Jun10rS1/Projet1AB_2026/README.md

# Projet1AB_2026
Notre projet comptage de personne

## Pense bete Git

```bash
git pull
# travail travail travail
git status
git add .
git commit -m "texte intelligent"
git push
```
