Jun10rS1/Projet1AB_2026/rapport fin de séance/Projet électronique séance 3.pdf

# Projet électronique séance 3

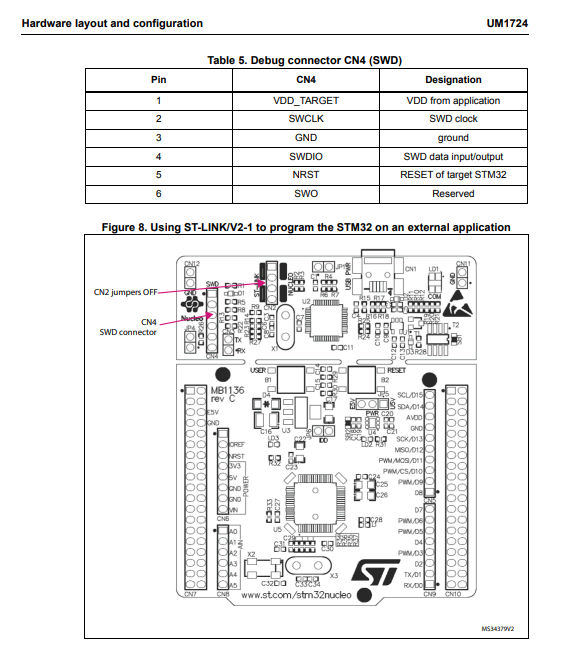
[picture p2: figure]

tableau de connection pour la programmation/débogage

## nomsConnections capteur-STM :

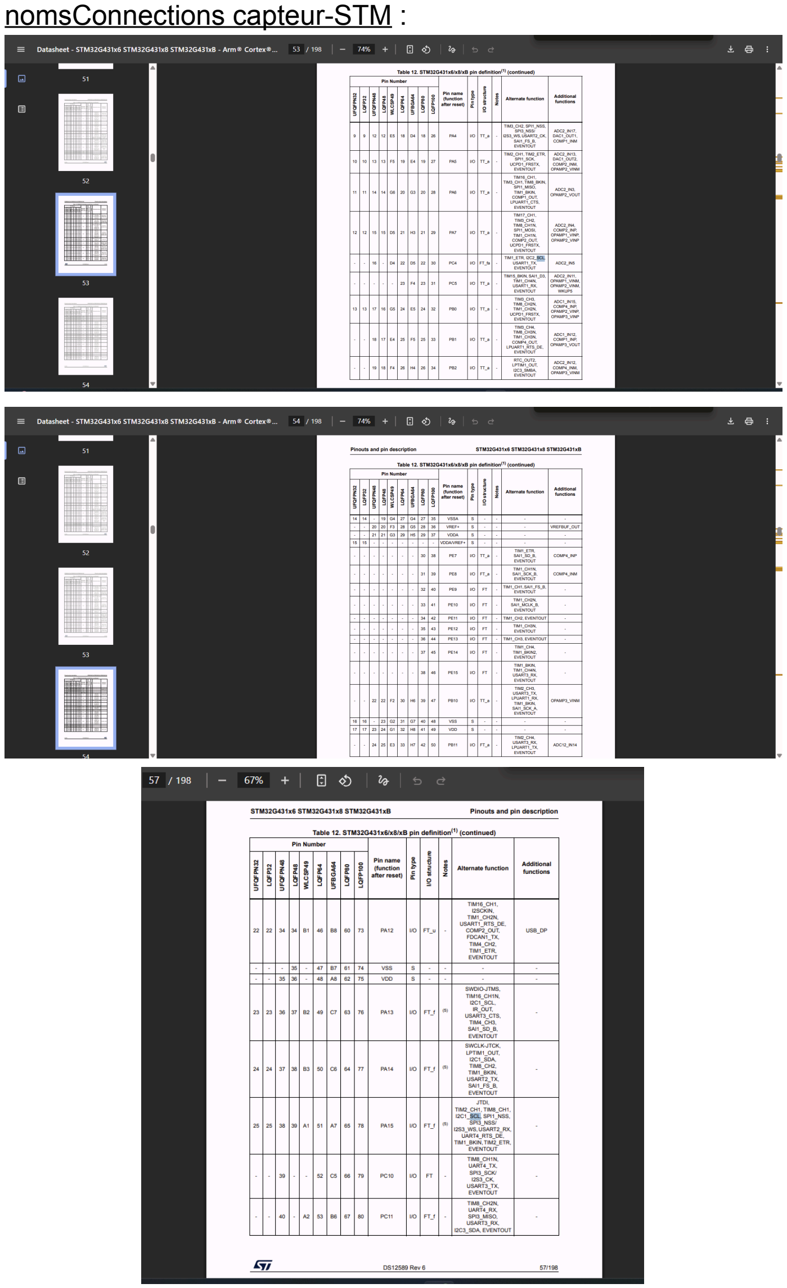
[picture p3: page 2]
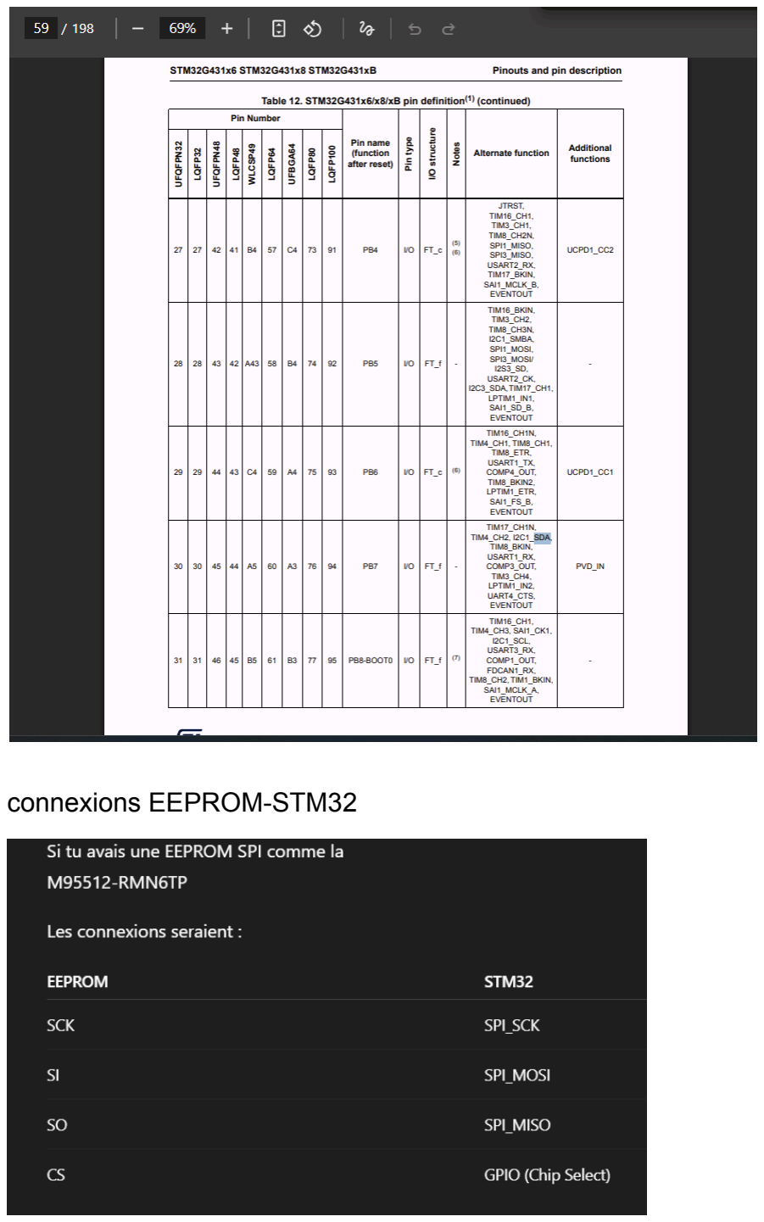
[picture p4: page 3]

## connexions EEPROM-STM32

boardhttps://www.st.com/resource/en/application_note/an5717-how-to-setup-and-run-the-vl53l5c xsatelusing-an-stm32-nucleo64-board-stmicroelectronics.pdf (http://www.st.com/resource/en/application_note/an5717-how-to-setup-and-run-the-vl53l5cxsatelusing-an-stm32-nucleo64-board-stmicroelectronics.pdf)

How to use the VL53L5CX with STMicroelectronics' X-CUBE-TOF1 Time-of-Flight sensor software packages for STM32CubeMX:

https://www.st.com/resource/en/user_manual/um2974-how-to-use-the-vl53l5cx-with-stmicroelectr onics-xcubetof1-timeofflight-sensor-software-packages-for-stm32cubemx-stmicroelectronics.pdf
