Jun10rS1/Projet1AB_2026/rapport fin de séance/Projet électronique séance 2.pdf

# Projet électronique séance 2

## Assignation des tâches entre la séance 1 et la séance 2 :

- Maël : finir recherches sur l’EEPROM (datasheets …).

### - Gaëtan : finir recherches sur les capteurs pour savoir quel

type de connecteur SWD utiliser.

### - Imane : commencer à trouver comment avoir un projet STM32

fonctionnel pour faire fonctionner le connecteur.

### - Junior : créer un Drive où on pourra mettre tous les fichiers qu’on créera et toutes les documentations techniques comme les datasheets ou les liens déposés dans les différents

comptes-rendus => plutôt un Git.

### Conditions de mesure avec le capteur VL53L5CX (cf datasheet VL53L5CX p.21) :

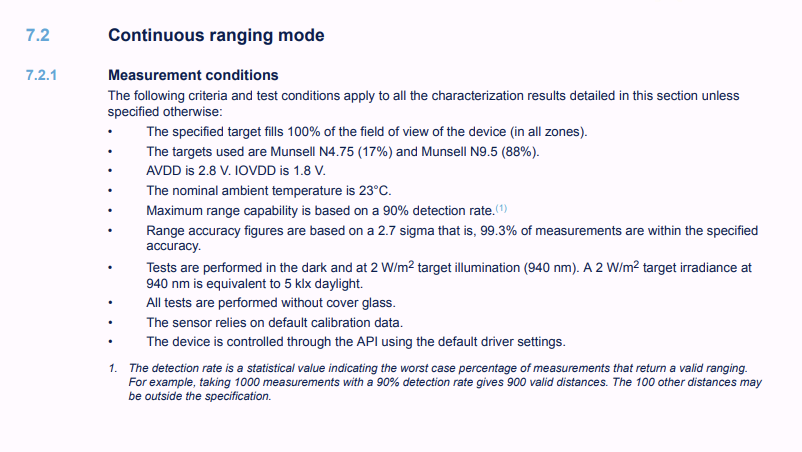
[picture p5: figure]

### - comment avoir un projet STM32 fonctionnel pour faire fonctionner le connecteur:

Dans notre projet, on utilise :

- une carte NUCLEO
- deux capteurs
- TeraTerm pour voir les données sur le PC

Donc on va probablement utiliser :

- I2C pour communiquer entre la STM32 et les capteurs
- UART pour envoyer les données vers le PC (affichage dans TeraTerm)

Etapes:

- Créer un nouveau projet avec la bonne carte (NUCLEO-L476)
- Pour l’affichage sur le PC → UART

Pour afficher les données dans TeraTerm, on utilise UART2.

Dans CubeIDE :

Activer USART2, Mode Asynchronous,Baud rate : 115200 et 8 bits

- Pour les capteurs → I2C(pas sûre si le prof a fait ça)

Les capteurs communiquent avec la STM32 en I2C.

Donc dans STM32CubeIDE : On active I2C1 ,Les pins SDA et SCL se configurent automatiquement et On laisse la fréquence à 100 kHz

- Utilisation de TeraTerm

TeraTerm est un logiciel de terminal série.

Il permet de :voir les données envoyées par la carte, tester si la communication fonctionne
et afficher le compteur en direct

Configuration :

- Brancher la carte en USB
- Ouvrir TeraTerm
- Choisir le bon port COM
- Régler le baud rate à 115200

Connecteur SWD pour le PCB : Conn_02x05_Top_Bottom.

Pour la semaine prochaine :inventaire des composants

pdf du schéma kicad

pdf du schéma pcb (selon l’avancement)

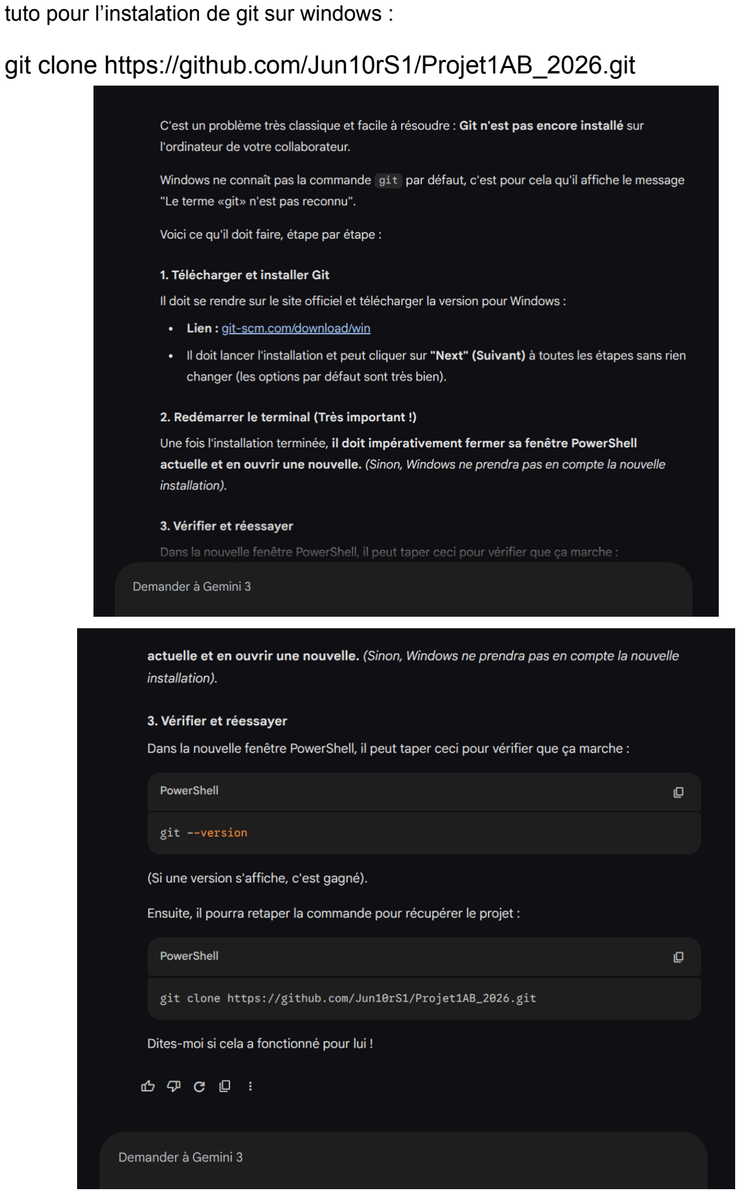
[picture p6: page 4]

tuto pour l’instalation de git sur windows :

git clone https://github.com/Jun10rS1/Projet1AB_2026.git

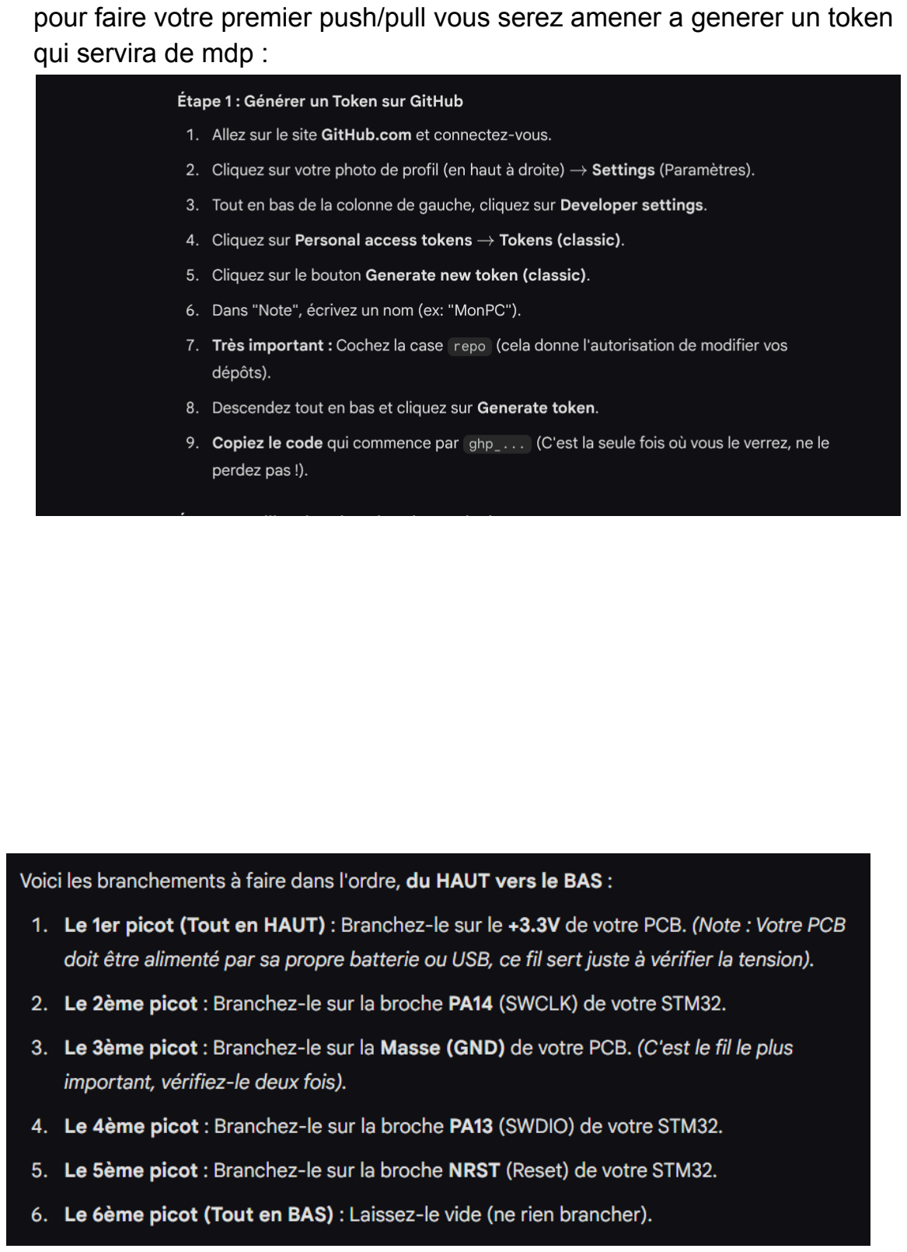
[picture p7: page 5]

pour faire votre premier push/pull vous serez amener a generer un token qui servira de mdp :

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
n : g

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
