Jun10rS1/Projet1AB_2026/rapport fin de séance/Project électronique séance 4.pdf

## Project électronique séance 4

Structure du code :

1 2 3 4 5 6 7 8

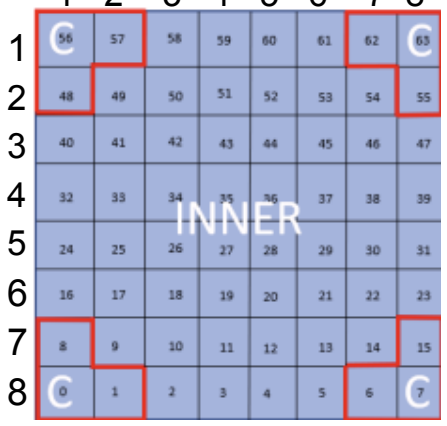
[picture p8: figure]

On prend deux colonnes de référence par côté de la matrice, par exemple les colonnes 2 et 4 pour le côté gauche, et la colonne 8 pour le côté droit :

- Si les distances par rapport au capteur sur la colonne 2 diminuent jusqu’à être inférieures seuil choisi avant que les distances de la colonne 4 ne passent en dessous du seuil, alors le capteur considère que quelque chose arrive par le côté gauche.
- Ensuite, si après ça les distances par rapport au capteur de la colonne 8 diminuent en dessous du seuil pour ensuite repasser au dessus du seuil, alors cela signifie que le capteur considère que quelque chose a traversé la zone du capteur : => Le capteur ajoute alors 1 au compteur de passages.
- De même dans l’autre sens en prenant cette fois en compte les colonnes 7 et 5 pour le côté droit, et la colonne 1 pour le côté gauche (côté de sortie) :
=> Le compteur retire alors 1 au compteur de passages.

a faire sur git a la suite (pour gaetan ) :

git fetch origin

git reset --hard origin/main

(optionelew mais recommandé ) :
git clean -fd

à faire pour la prochaine séance :
Travailler chacun sur code et communiquer en cas.
