Jun10rS1/Projet1AB_2026/Projet PCB kiCad/Projet PCB kiCad - Copie/Projet électronique séance 3 (liste de composant G4).pdf

# Projet électronique (G4 comptage)

Liste des composants :

Référence | Valeur / Modèle | Empreinte utillisé
C1, C2, C7 | 1u | Capacitor_SMD:C_0603_1608Metri c
C3, C9, C10 | 100n | Capacitor_SMD:C_0603_1608Metri c
C6 | 10n | Capacitor_SMD:C_0603_1608Metri c
C8 | 4u | Capacitor_SMD:C_0603_1608Metri c
D1, D2 | LED_Small | LED_SMD:LED_0201_0603Metric
H1 - H4 | Mounting Hole | MountingHole_3.2mm_M3
IC1 (EEPROM) | M95512-RMN6TP | Package_SO:SOIC-8_3.9x4.9mm
J1 | Conn_01x02 | JST_XH_B2B-XH-A_1x02_P2.50m m

J5 | Conn_01x09_Pin | PinSocket_1x09_P2.54mm
J6 | Conn_02x05 | PinHeader_2x05_P2.54mm
L1 | 39n | Inductor_SMD:L_0805_2012Metric
R1 | 10k | Resistor_SMD:R_0201_0603Metric
R3, R4 | 1k | Resistor_SMD:R_0201_0603Metric
U2 | BU33SD5WG-TR | Package_TO_SOT_SMD:SOT-23-5
U4 | STM32G431K8Tx | Package_QFP:LQFP-32_7x7mm
