Jun10rS1/Projet1AB_2026/Projet PCB kiCad/Projet PCB kiCad - Copie/PDF/PCB projet fin séance 4.pdf

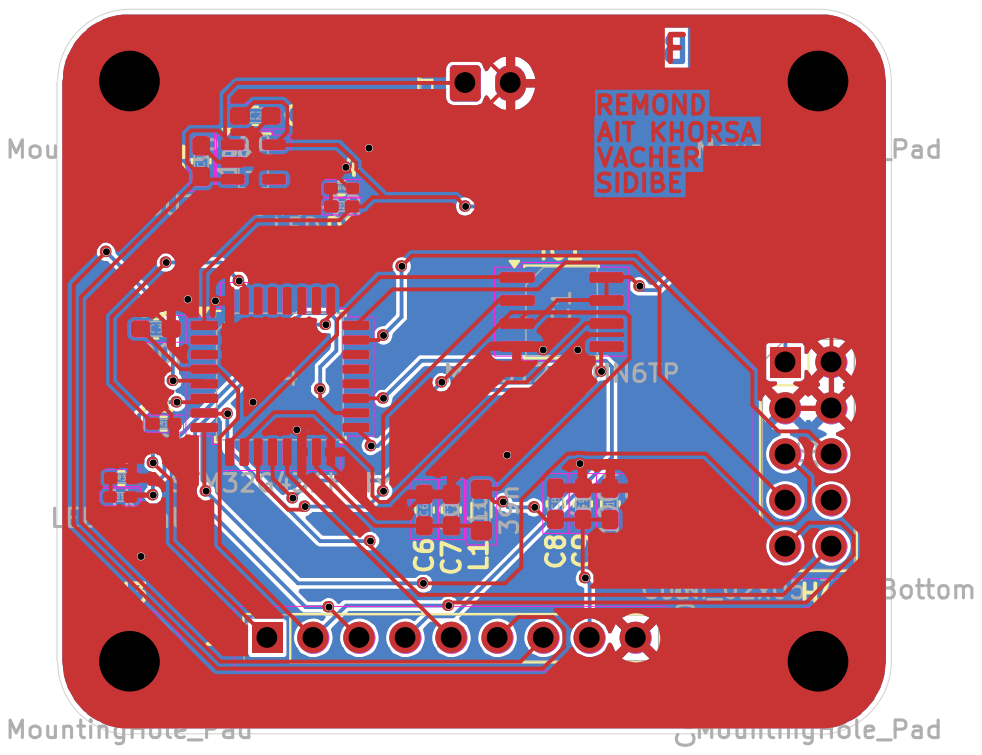
[picture p9: page 1]
