Jun10rS1/Projet1AB_2026/Projet PCB kiCad/Projet PCB kiCad - Copie/PDF/Schéma fin séance 3.pdf

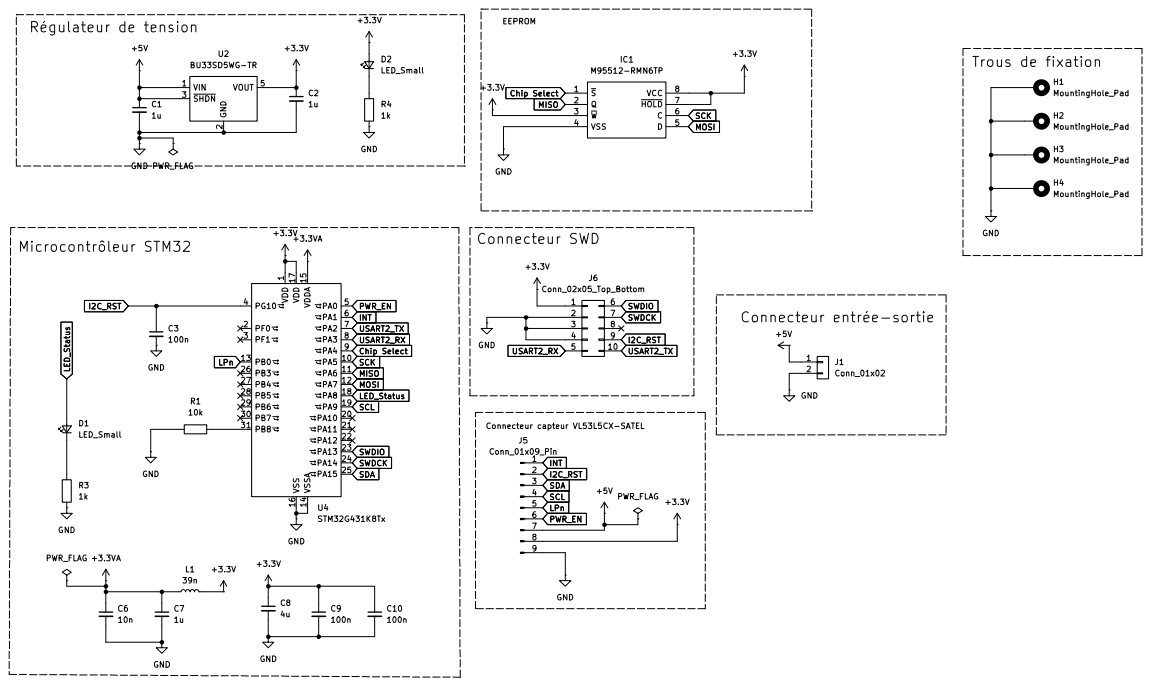
[picture p10: page 1]
