Jun10rS1/Projet1AB_2026/Projet PCB kiCad/Projet PCB kiCad - Copie/PDF/PCB fin séance 2.pdf

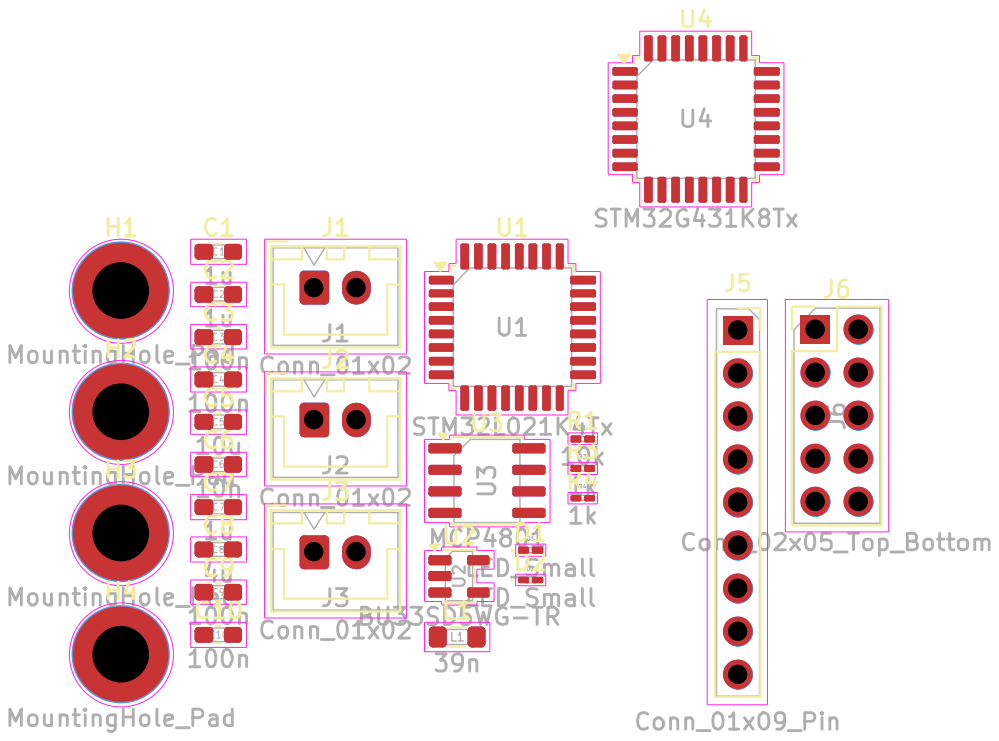
[picture p11: page 1]
