Jun10rS1/Projet1AB_2026/Projet PCB kiCad/Projet PCB kiCad - Copie/PDF/Schéma fin séance 2.pdf

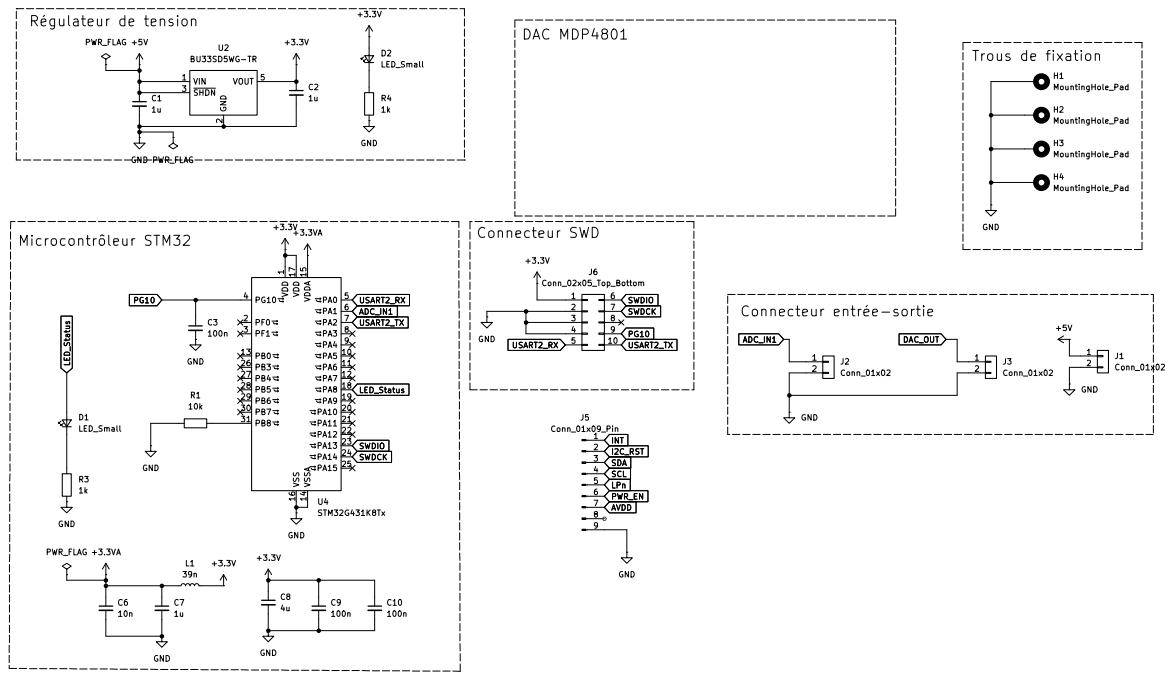
[picture p12: page 1]
