Jun10rS1/Projet1AB_2026/(list of files, drawings)

Other design files:
LIB_M95512-RMN6TP/M95512-RMN6TP/Altium/M95512-RMN6TP.SchLib
LIB_M95512-RMN6TP/M95512-RMN6TP/Altium/SOIC127P600X175-8N.PcbLib
