Jun10rS1/Projet1AB_2026/Projet PCB kiCad/Projet PCB kiCad - Copie/Projet PCB kiCad.kicad_pcb

## KiCad design Projet PCB kiCad/Projet PCB kiCad - Copie/Projet PCB kiCad.kicad_pcb (2026-03-16, an earlier design)

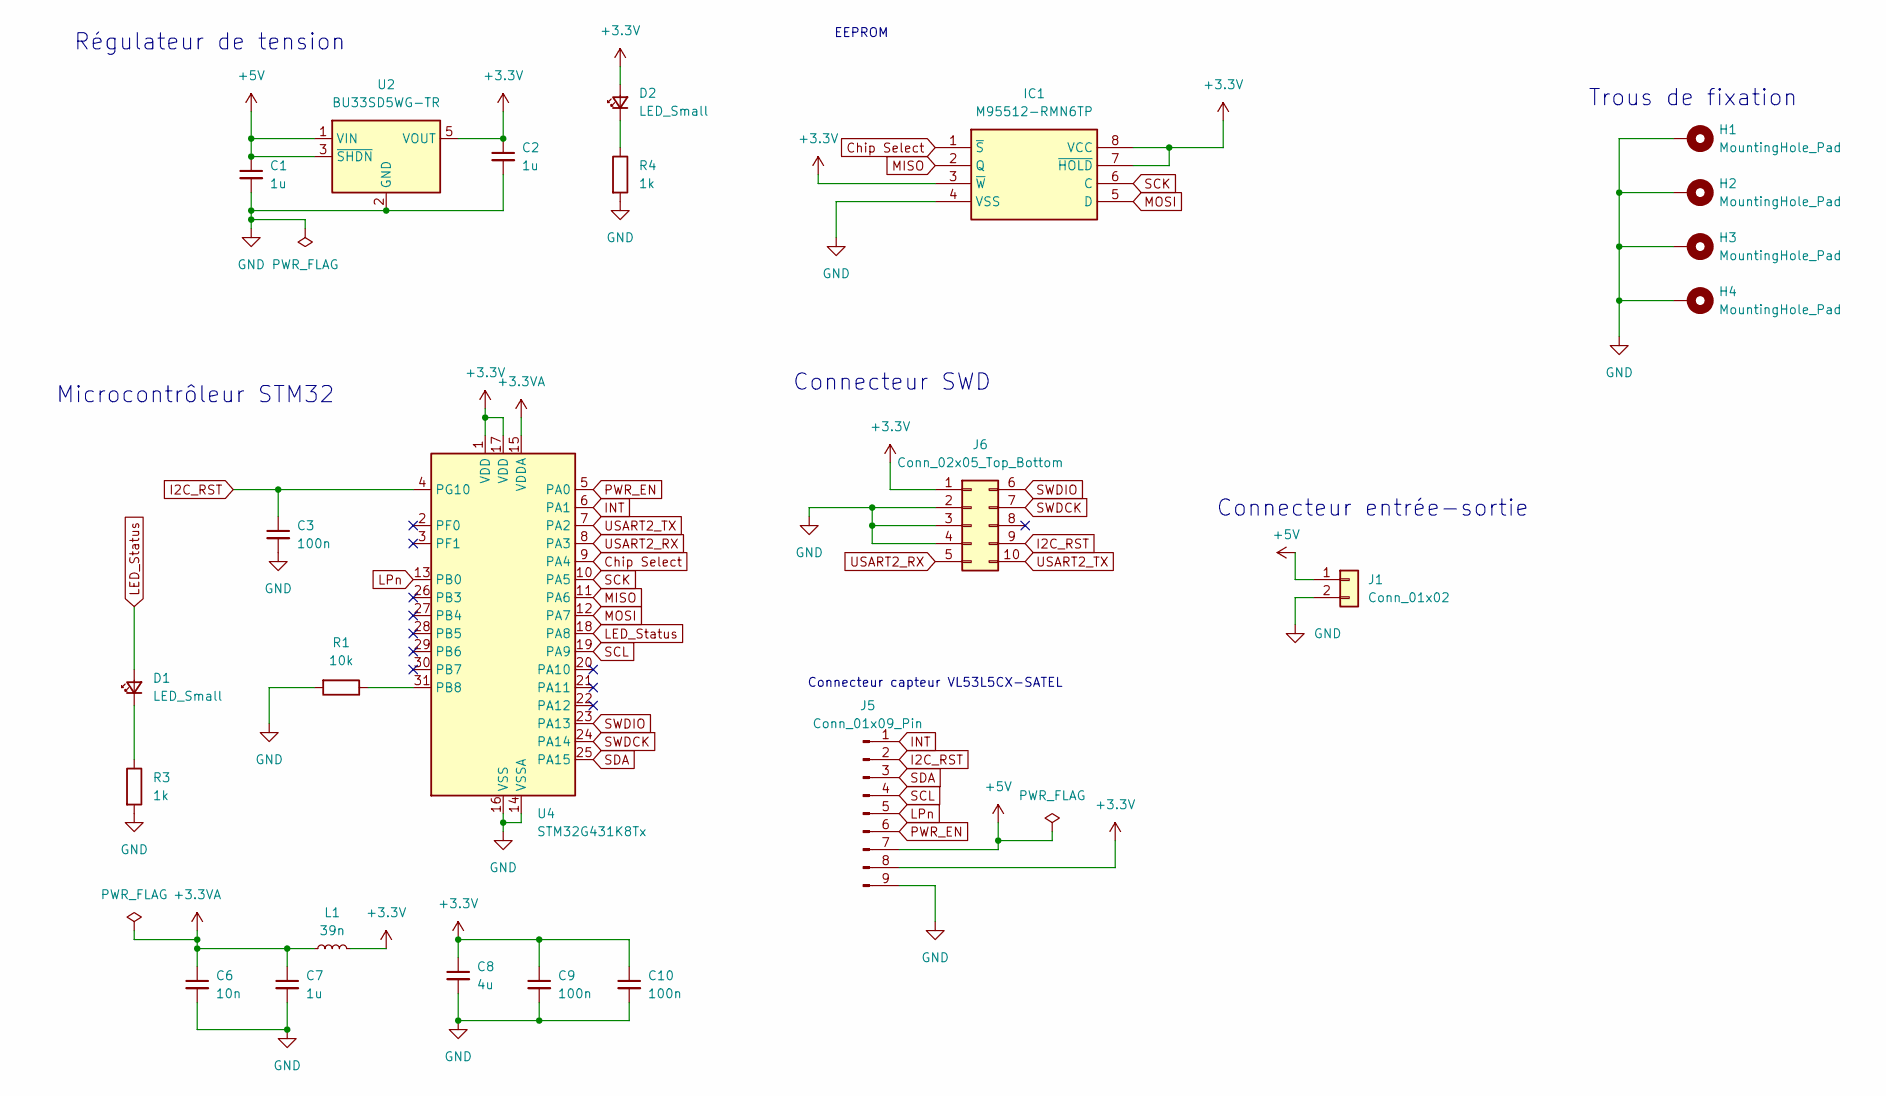
[picture p13: schematic Projet PCB kiCad.kicad_sch, Projet électronique Rémond, Ait Khorsa, Sidibe, Vacher]

Parts:
C1, C2, C7: 1u; C_0603_1608Metric_Pad1.08x0.95mm_HandSolder
C3, C9, C10: 100n; C_0603_1608Metric_Pad1.08x0.95mm_HandSolder
C6: 10n; C_0603_1608Metric_Pad1.08x0.95mm_HandSolder
C8: 4u; C_0603_1608Metric_Pad1.08x0.95mm_HandSolder
D1, D2: LED_Small; LED_0402_1005Metric_Pad0.77x0.64mm_HandSolder
H1, H2, H3, H4: MountingHole_Pad; MountingHole_3.2mm_M3_DIN965_Pad
IC1: M95512-RMN6TP; SOIC-8_3.9x4.9mm_P1.27mm; Mouser Part Number 511-M95512-RMN6TP
J1: Conn_01x02; JST_XH_B2B-XH-A_1x02_P2.50mm_Vertical
J5: Conn_01x09_Pin; PinSocket_1x09_P2.54mm_Vertical
J6: Conn_02x05_Top_Bottom; PinHeader_2x05_P2.54mm_Vertical
L1: 39n; L_0805_2012Metric_Pad1.05x1.20mm_HandSolder
R1: 10k; R_0402_1005Metric_Pad0.72x0.64mm_HandSolder
R3, R4: 1k; R_0402_1005Metric_Pad0.72x0.64mm_HandSolder
U2: BU33SD5WG-TR; SOT-23-5
U4: STM32G431K8Tx; LQFP-32_7x7mm_P0.8mm

Connections:
+3.3V: C2.1, C8.1, C9.1, C10.1, D2.2 (A), IC1.3 (~W), IC1.7 (~HOLD), IC1.8 (VCC), J5.8, J6.1, L1.2, U2.5 (VOUT), U4.1 (VDD), U4.17 (VDD)
+3.3VA: C6.1, C7.1, L1.1, U4.15 (VDDA)
+5V: C1.1, J1.1, J5.7, U2.1 (VIN), U2.3 (~SHDN)
Chip Select: IC1.1 (~S), U4.9 (PA4)
GND: C1.2, C2.2, C3.2, C6.2, C7.2, C8.2, C9.2, C10.2, H1.1, H2.1, H3.1, H4.1, IC1.4 (VSS), J1.2, J5.9, J6.2, J6.3, J6.4, R1.2, R3.2, R4.2, U2.2 (GND), U4.14 (VSSA), U4.16 (VSS), U4.32 (VSS)
I2C_RST: C3.1, J5.2, J6.9, U4.4 (PG10)
INT: J5.1, U4.6 (PA1)
LED_Status: D1.2 (A), U4.18 (PA8)
LPn: J5.5, U4.13 (PB0)
MISO: IC1.2 (Q), U4.11 (PA6)
MOSI: IC1.5 (D), U4.12 (PA7)
unnamed: D1.1 (K), R3.1
unnamed: D2.1 (K), R4.1
unnamed: R1.1, U4.31 (PB8)
PWR_EN: J5.6, U4.5 (PA0)
SCK: IC1.6 (C), U4.10 (PA5)
SCL: J5.4, U4.19 (PA9)
SDA: J5.3, U4.25 (PA15)
SWDCK: J6.7, U4.24 (PA14)
SWDIO: J6.6, U4.23 (PA13)
USART2_RX: J6.5, U4.8 (PA3)
USART2_TX: J6.10, U4.7 (PA2)

Notes on the sheet:
Trous de fixation
Connecteur entrée-sortie
Microcontrôleur STM32
Connecteur SWD
Régulateur de tension
EEPROM
Connecteur capteur VL53L5CX-SATEL

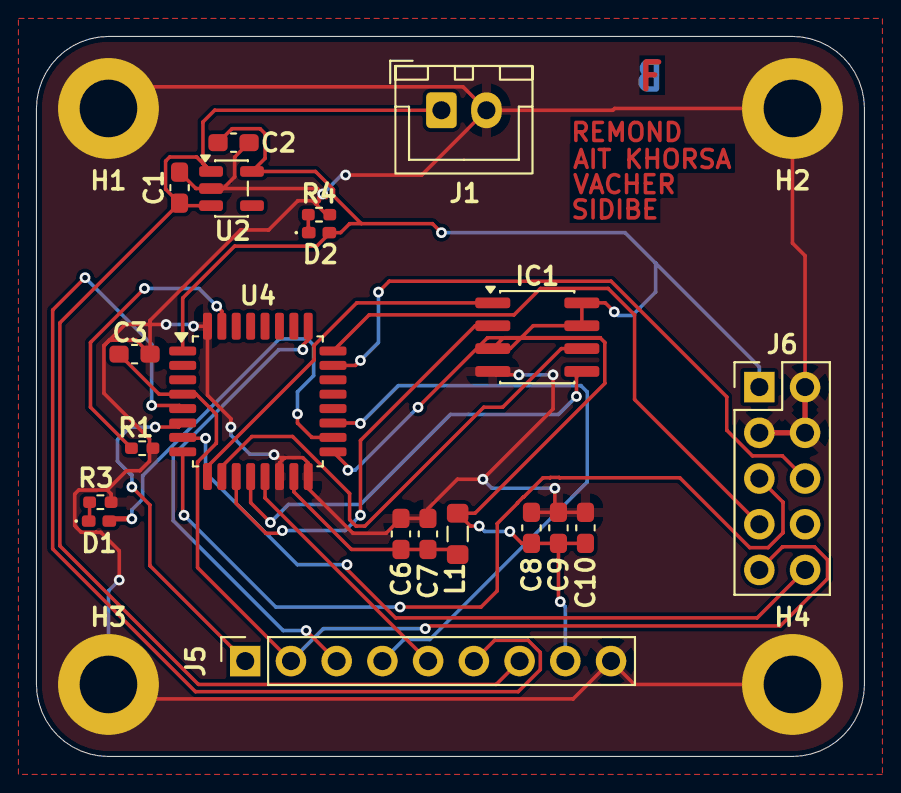
[picture p14: board Projet PCB kiCad.kicad_pcb from above]

Board: 4 copper layers, 46.0 x 40.0 mm, 24 parts (0 on the bottom side), 22 nets.
