Jun10rS1/Projet1AB_2026/Comptage_Presence4/Core/Src/main.c

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
/* Includes ------------------------------------------------------------------*/
#include "main.h"

/* USER CODE BEGIN Includes */
#include "vl53l5cx_api.h"
/* USER CODE END Includes */

/* USER CODE BEGIN PD */
#define HAL_UART_MODULE_ENABLED
/* USER CODE END PD */

I2C_HandleTypeDef hi2c2;

/* USER CODE BEGIN PV */
VL53L5CX_Configuration 	Dev;
VL53L5CX_ResultsData 	Results;

#define DIST_THRESHOLD_MM 1000

typedef enum {
    STATE_IDLE,
    STATE_WAIT_EXIT_RIGHT,
    STATE_WAIT_EXIT_LEFT
} CountState_t;

CountState_t currentState = STATE_IDLE;
int32_t passageCounter = 0;
uint8_t flagTargetInExitCol = 0;
/* USER CODE END PV */

void SystemClock_Config(void);
static void MX_GPIO_Init(void);
static void MX_I2C2_Init(void);
/* USER CODE BEGIN PFP */
uint32_t Get_Column_Average(VL53L5CX_ResultsData *pResults, uint8_t col_index);
/* USER CODE END PFP */

/**
  * @brief  The application entry point.
  * @retval int
  */
int main(void)
{

  /* MCU Configuration--------------------------------------------------------*/

  /* Reset of all peripherals, Initializes the Flash interface and the Systick. */
  HAL_Init();

  /* Configure the system clock */
  SystemClock_Config();

  /* Initialize all configured peripherals */
  MX_GPIO_Init();
  MX_I2C2_Init();
  /* USER CODE BEGIN 2 */
  /* USER CODE BEGIN 2 */

    HAL_GPIO_WritePin(GPIOB, GPIO_PIN_0, GPIO_PIN_RESET);
    HAL_Delay(20);
    HAL_GPIO_WritePin(GPIOB, GPIO_PIN_0, GPIO_PIN_SET);
    HAL_Delay(100);

    Dev.platform.address = 0x52;
    Dev.platform.i2c_handle = &hi2c2;

    uint8_t isAlive = 0;
    uint8_t status = vl53l5cx_is_alive(&Dev, &isAlive);

    if (status == 0 && isAlive) {
        printf("Capteur détecté\r\n");
        vl53l5cx_init(&Dev);
        vl53l5cx_set_resolution(&Dev, VL53L5CX_RESOLUTION_8X8);
        vl53l5cx_set_ranging_frequency_hz(&Dev, 15);
        vl53l5cx_start_ranging(&Dev);
    } else {
        printf("ERREUR : Capteur non détecté\r\n");
    }
  /* USER CODE END 2 */

  /* Infinite loop */
  /* USER CODE BEGIN WHILE */
    while (1)
      {
          uint8_t isReady = 0;
          vl53l5cx_check_data_ready(&Dev, &isReady);

          if (isReady) {
              vl53l5cx_get_ranging_data(&Dev, &Results);
              uint32_t avgCol0 = Get_Column_Average(&Results, 0);
              uint32_t avgCol3 = Get_Column_Average(&Results, 3);
              uint32_t avgCol4 = Get_Column_Average(&Results, 4);
              uint32_t avgCol7 = Get_Column_Average(&Results, 7);

              switch(currentState) {

                  case STATE_IDLE:
                      if (avgCol3 < DIST_THRESHOLD_MM) {
                          currentState = STATE_WAIT_EXIT_RIGHT;
                          flagTargetInExitCol = 0;
                      }
                      else if (avgCol4 < DIST_THRESHOLD_MM) {
                          currentState = STATE_WAIT_EXIT_LEFT;
                          flagTargetInExitCol = 0;
                      }
                      break;

                  case STATE_WAIT_EXIT_RIGHT:
                      if (avgCol7 < DIST_THRESHOLD_MM) {
                          flagTargetInExitCol = 1;
                      }
                      else if (flagTargetInExitCol && avgCol7 >= DIST_THRESHOLD_MM) {
                          passageCounter++;
                          currentState = STATE_IDLE;
                      }
                      break;

                  case STATE_WAIT_EXIT_LEFT:
                      if (avgCol0 < DIST_THRESHOLD_MM) {
                          flagTargetInExitCol = 1;
                      }
                      else if (flagTargetInExitCol && avgCol0 >= DIST_THRESHOLD_MM) {
                          passageCounter--;
                          currentState = STATE_IDLE;
                      }
                      break;
              }
          }
    /* USER CODE END WHILE */

    /* USER CODE BEGIN 3 */
  }

  /* USER CODE END 3 */
}

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
/* USER CODE BEGIN 4 */
uint32_t Get_Column_Average(VL53L5CX_ResultsData *pResults, uint8_t col_index) {
    uint32_t sum = 0;
    uint8_t valid_zones = 0;

    for (int row = 0; row < 8; row++) {
        uint8_t zone = (row * 8) + col_index;

        if (pResults->target_status[VL53L5CX_NB_TARGET_PER_ZONE * zone] == 5 ||
            pResults->target_status[VL53L5CX_NB_TARGET_PER_ZONE * zone] == 9) {

            sum += pResults->distance_mm[VL53L5CX_NB_TARGET_PER_ZONE * zone];
            valid_zones++;
        }
    }

    if (valid_zones == 0) return 9999;
    return (sum / valid_zones);
}
/* USER CODE END 4 */
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
