Jun10rS1/Projet1AB_2026/Comptage_Presence/Comptage_Presence.ioc

Mcu.UserName=STM32L476RGTx
PA2.GPIO_Label=USART_TX
PA2.Signal=USART2_TX
PA3.GPIO_Label=USART_RX
PA3.Signal=USART2_RX
PA4.Signal=GPIO_Output
PA5.Signal=SPI1_SCK
PA6.Signal=SPI1_MISO
PA7.Signal=SPI1_MOSI
PB10.Signal=I2C2_SCL
PB11.Signal=I2C2_SDA
PB8.Signal=GPIO_Output
PB9.Signal=I2C1_SDA
PC13.GPIO_Label=B1 [Blue PushButton]
PC13.Signal=GPXTI13
