Jun10rS1/Projet1AB_2026/Comptage_Presence4/Core/Inc/main.h

#define VL53_INT_Pin GPIO_PIN_1
#define VL53_INT_GPIO_Port GPIOA
#define VL53_LPn_Pin GPIO_PIN_0
#define VL53_LPn_GPIO_Port GPIOB
