Jun10rS1/Projet1AB_2026/(commit log)

2026-02-09 premier push
    [EDI2CAP.CFG, M95512-RMN6TP.SchLib, M95512-RMN6TP.stp, SOIC127P600X175-8N.PcbLib, chips.prt]
2026-02-09 schema kicad
2026-02-16 ajout des rapports de fin de séance
2026-02-16 ajout du kicad
    [EDI2CAP.CFG, M95512-RMN6TP.SchLib, M95512-RMN6TP.stp, Projet PCB kiCad.kicad_pcb, Projet PCB kiCad.kicad_sch, SOIC127P600X175-8N.PcbLib, chips.prt]
2026-02-16 kicad eeprom
    [Projet PCB kiCad.kicad_sch]
2026-02-16 ajout des datasheet
    [Projet PCB kiCad.kicad_sch]
2026-02-16 Kicad fin schema
    [Projet PCB kiCad.kicad_pcb, Projet PCB kiCad.kicad_sch]
2026-03-09 repertoire DRC
    [20260112_JLCPCB_2_layers_drc.kicad_pcb]
2026-03-09 fin de kicad
    [EDI2CAP.CFG, M95512-RMN6TP.SchLib, M95512-RMN6TP.stp, Projet PCB kiCad.kicad_pcb, Projet PCB kiCad.kicad_sch, SOIC127P600X175-8N.PcbLib, chips.prt]
2026-03-16 rapport séance 4
    [Projet PCB kiCad.kicad_pcb]
