Jun10rS1/Projet1AB_2026/(notices)

Notices in the files:
Comptage_Presence4/Core/Src/main.c:
Copyright (c) 2026 STMicroelectronics.
All rights reserved.
